MarcEftimie/AD9837-synchronizer/(commit log)

2023-04-05 SPI communication
2023-04-07 changed register reset order
    [AD9837.ino]
